Pmitrega/LinefollowerV3/matlab_learn_NN/lfmap_div4_sizemm.bmp

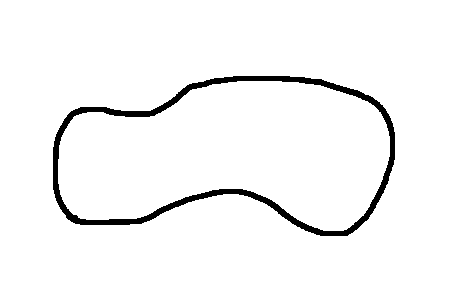
matlab_learn_NN/lfmap_div4_sizemm.bmp
