Pmitrega/LinefollowerV3/matlab_simulation/Robot_simulink/lfmap2.bmp

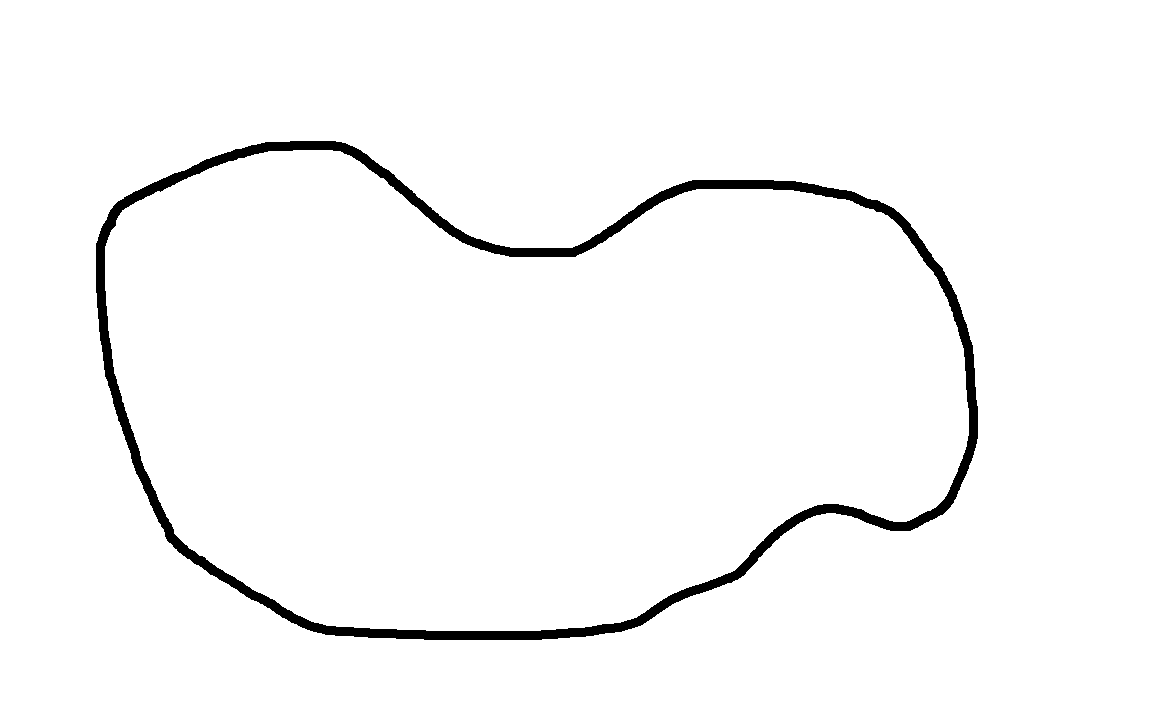
matlab_simulation/Robot_simulink/lfmap2.bmp
