Pmitrega/LinefollowerV3/matlab_simulation/Robot_simulink/robot_im.bmp

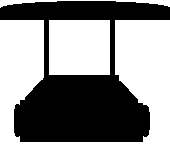
matlab_simulation/Robot_simulink/robot_im.bmp
