Pmitrega/LinefollowerV3/(list of files, cad)

Other CAD files:
modele_3d/connector_meta_v2l.ipt
modele_3d/formav2.ipt
modele_3d/kolov2.ipt
