Pmitrega/LinefollowerV3/BOARD_lfv3_1/BOARD_lfv3.kicad_pcb

## KiCad design BOARD_lfv3_1/BOARD_lfv3.kicad_pcb (2023-09-13)

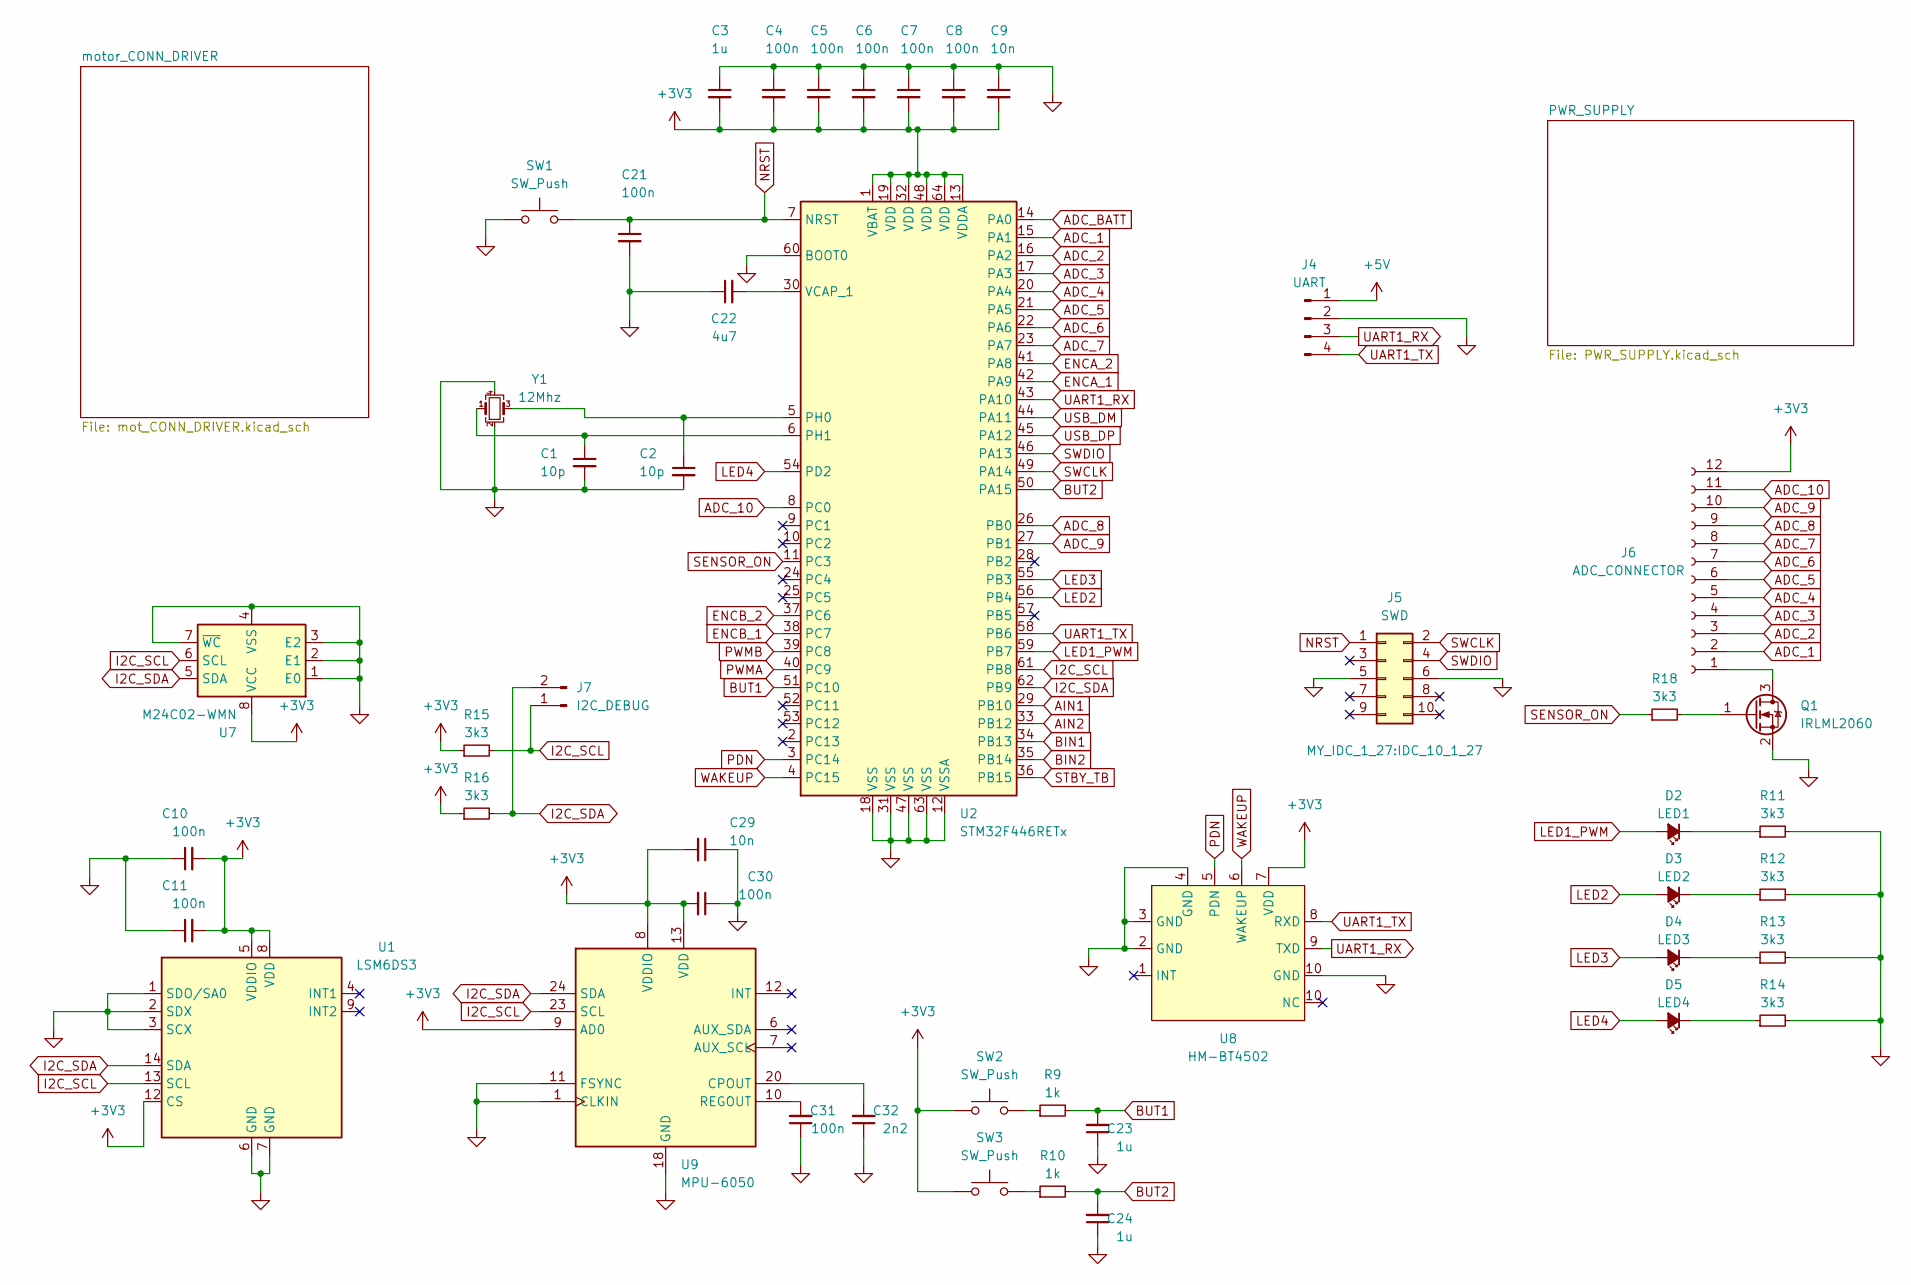
[picture p4: schematic BOARD_lfv3.kicad_sch]

Parts:
C1, C2: 10p; C_0603_1608Metric_Pad1.08x0.95mm_HandSolder
C3, C23, C24: 1u; C_0603_1608Metric_Pad1.08x0.95mm_HandSolder
C4, C5, C6, C7, C8, C10, C11, C21, C30, C31: 100n; C_0603_1608Metric_Pad1.08x0.95mm_HandSolder
C9, C29: 10n; C_0603_1608Metric_Pad1.08x0.95mm_HandSolder
C22: 4u7; C_0603_1608Metric_Pad1.08x0.95mm_HandSolder
C32: 2n2; C_0603_1608Metric_Pad1.08x0.95mm_HandSolder
D2: LED1; LED_0603_1608Metric_Pad1.05x0.95mm_HandSolder
D3: LED2; LED_0603_1608Metric_Pad1.05x0.95mm_HandSolder
D4: LED3; LED_0603_1608Metric_Pad1.05x0.95mm_HandSolder
D5: LED4; LED_0603_1608Metric_Pad1.05x0.95mm_HandSolder
J4: UART; PinSocket_1x04_P2.54mm_Vertical
J5: SWD; IDC_10_1_27
J6: ADC_CONNECTOR; Hirose_FH12-12S-0.5SH_1x12-1MP_P0.50mm_Horizontal
J7: I2C_DEBUG; PinHeader_1x02_P2.54mm_Vertical
Q1: IRLML2060; SOT-23
R9, R10: 1k; R_0603_1608Metric_Pad0.98x0.95mm_HandSolder
R11, R12, R13, R14, R15, R16, R18: 3k3; R_0603_1608Metric_Pad0.98x0.95mm_HandSolder
SW1, SW2, SW3: SW_Push; SW_SPST_TL3342
U1: LSM6DS3; LGA-14_3x2.5mm_P0.5mm_LayoutBorder3x4y
U2: STM32F446RETx; LQFP-64_10x10mm_P0.5mm
U7: M24C02-WMN; SOIC-8_3.9x4.9mm_P1.27mm
U8: HM-BT4502; HM-BT4502_kopia
U9: MPU-6050; InvenSense_QFN-24_4x4mm_P0.5mm
Y1: 12Mhz; Crystal_SMD_3225-4Pin_3.2x2.5mm_HandSoldering

Connections:
+3V3: C3.2, C4.2, C5.2, C6.2, C7.2, C8.2, C9.2, C10.2, C11.2, C29.2, C30.2, J6.12, R15.1, R16.1, SW2.1, SW3.1, U1.5 (VDDIO), U1.8 (VDD), U1.12 (CS), U2.1 (VBAT), U2.13 (VDDA), U2.19 (VDD), U2.32 (VDD), U2.48 (VDD), U2.64 (VDD), U7.8 (VCC), U8.7 (VDD), U9.8 (VDDIO), U9.9 (AD0), U9.13 (VDD); also elsewhere on the board
+5V: J4.1; also elsewhere on the board
ADC_1: J6.2, U2.15 (PA1)
ADC_2: J6.3, U2.16 (PA2)
ADC_3: J6.4, U2.17 (PA3)
ADC_4: J6.5, U2.20 (PA4)
ADC_5: J6.6, U2.21 (PA5)
ADC_6: J6.7, U2.22 (PA6)
ADC_7: J6.8, U2.23 (PA7)
ADC_8: J6.9, U2.26 (PB0)
ADC_9: J6.10, U2.27 (PB1)
ADC_10: J6.11, U2.8 (PC0)
ADC_BATT: U2.14 (PA0); also elsewhere on the board
AIN1: U2.29 (PB10); also elsewhere on the board
AIN2: U2.33 (PB12); also elsewhere on the board
BIN1: U2.34 (PB13); also elsewhere on the board
BIN2: U2.35 (PB14); also elsewhere on the board
BUT1: C23.2, R9.2, U2.51 (PC10)
BUT2: C24.2, R10.2, U2.50 (PA15)
ENCA_1: U2.42 (PA9); also elsewhere on the board
ENCA_2: U2.41 (PA8); also elsewhere on the board
ENCB_1: U2.38 (PC7); also elsewhere on the board
ENCB_2: U2.37 (PC6); also elsewhere on the board
GND: C1.2, C2.2, C3.1, C4.1, C5.1, C6.1, C7.1, C8.1, C9.1, C10.1, C11.1, C21.2, C22.1, C23.1, C24.1, C29.1, C30.1, C31.1, C32.1, J4.2, J5.5, J5.6, Q1.2 (S), R11.2, R12.2, R13.2, R14.2, SW1.1, U1.1 (SDO/SA0), U1.2 (SDX), U1.3 (SCX), U1.6 (GND), U1.7 (GND), U2.12 (VSSA), U2.18 (VSS), U2.31 (VSS), U2.47 (VSS), U2.60 (BOOT0), U2.63 (VSS), U7.1 (E0), U7.2 (E1), U7.3 (E2), U7.4 (VSS), U7.7 (~WC), U8.2 (GND), U8.3 (GND), U8.4 (GND), U8.10 (GND), U9.1 (CLKIN), U9.11 (FSYNC), U9.18 (GND), Y1.2, Y1.4; also elsewhere on the board
I2C_SCL: J7.1, R15.2, U1.13 (SCL), U2.61 (PB8), U7.6 (SCL), U9.23 (SCL)
I2C_SDA: J7.2, R16.2, U1.14 (SDA), U2.62 (PB9), U7.5 (SDA), U9.24 (SDA)
LED1_PWM: D2.2 (A), U2.59 (PB7)
LED2: D3.2 (A), U2.56 (PB4)
LED3: D4.2 (A), U2.55 (PB3)
LED4: D5.2 (A), U2.54 (PD2)
NRST: C21.1, J5.1, SW1.2, U2.7 (NRST)
unnamed: C1.1, U2.6 (PH1), Y1.1
unnamed: C2.1, U2.5 (PH0), Y1.3
unnamed: C22.2, U2.30 (VCAP_1)
unnamed: C31.2, U9.10 (REGOUT)
unnamed: C32.2, U9.20 (CPOUT)
unnamed: D2.1 (K), R11.1
unnamed: D3.1 (K), R12.1
unnamed: D4.1 (K), R13.1
unnamed: D5.1 (K), R14.1
unnamed: J6.1, Q1.3 (D)
unnamed: Q1.1 (G), R18.2
unnamed: R9.1, SW2.2
unnamed: R10.1, SW3.2
PDN: U2.3 (PC14), U8.5 (PDN)
PWMA: U2.40 (PC9); also elsewhere on the board
PWMB: U2.39 (PC8); also elsewhere on the board
SENSOR_ON: R18.1, U2.11 (PC3)
STBY_TB: U2.36 (PB15); also elsewhere on the board
SWCLK: J5.2, U2.49 (PA14)
SWDIO: J5.4, U2.46 (PA13)
UART1_RX: J4.3, U2.43 (PA10), U8.9 (TXD)
UART1_TX: J4.4, U2.58 (PB6), U8.8 (RXD)
USB_DM: U2.44 (PA11)
USB_DP: U2.45 (PA12)
WAKEUP: U2.4 (PC15), U8.6 (WAKEUP)

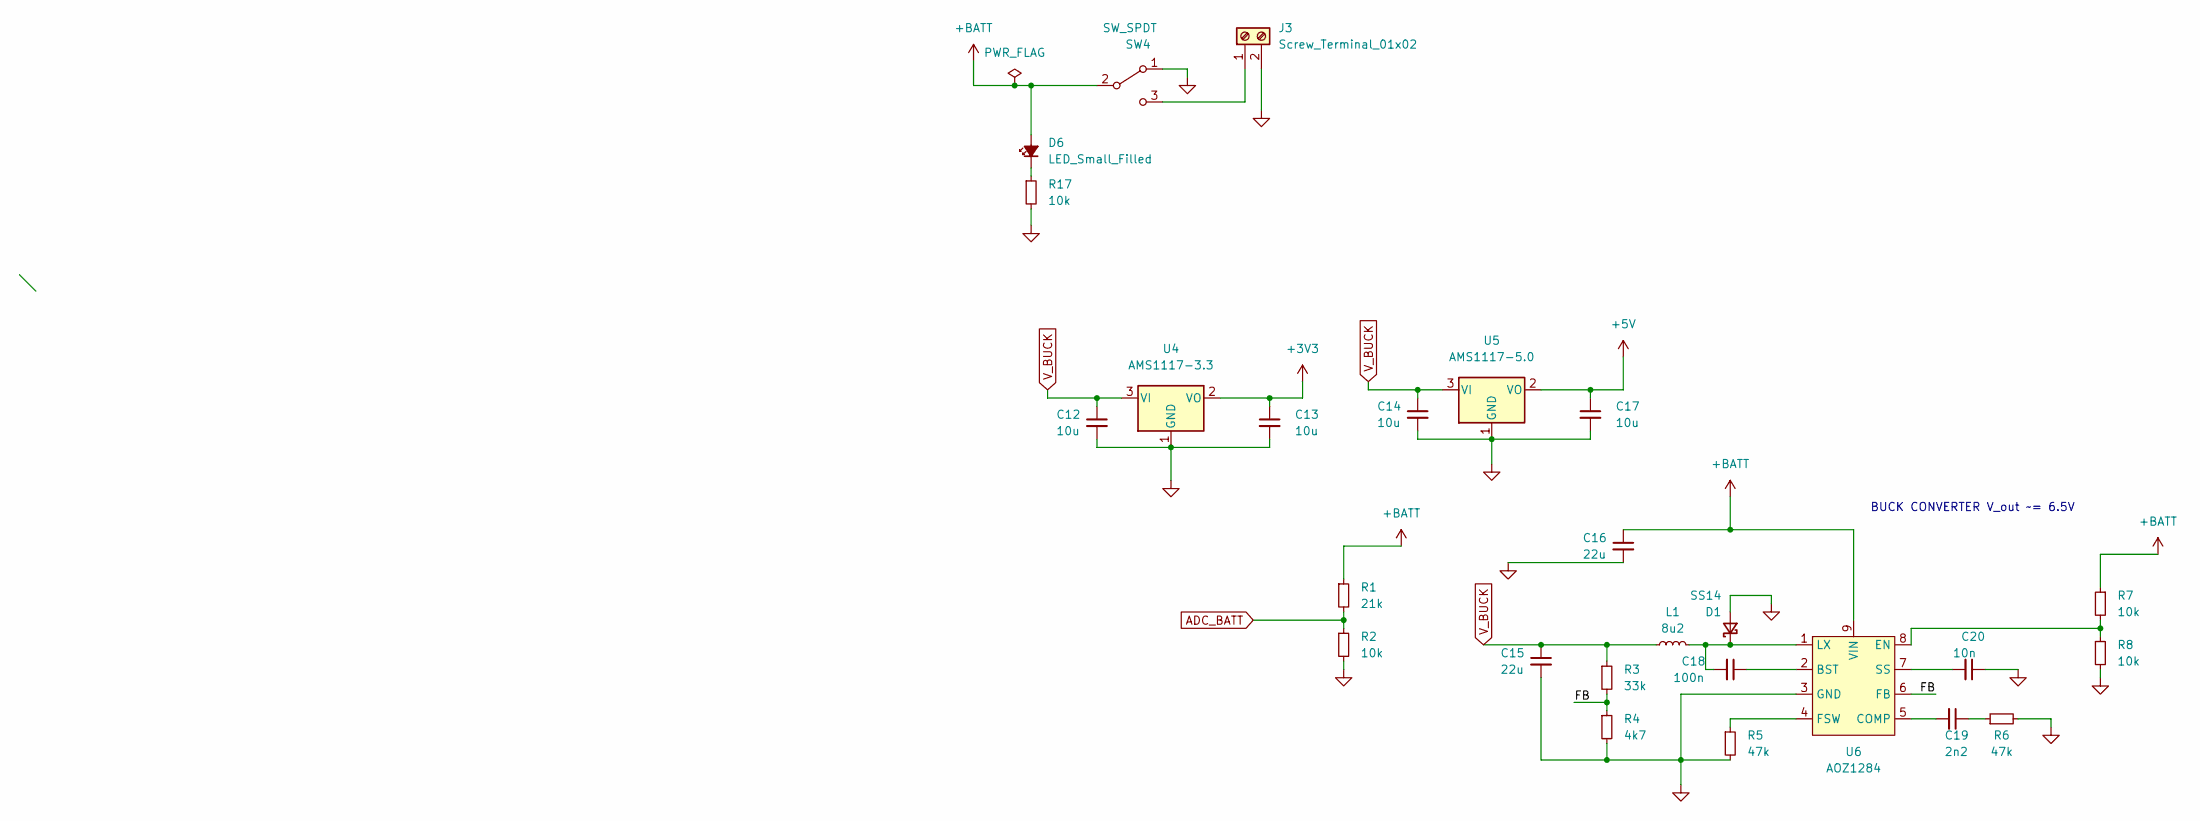
[picture p5: schematic PWR_SUPPLY.kicad_sch]

Parts:
C12, C13, C14, C17: 10u; C_0603_1608Metric_Pad1.08x0.95mm_HandSolder
C15, C16: 22u; C_0805_2012Metric_Pad1.18x1.45mm_HandSolder
C18: 100n; C_0603_1608Metric_Pad1.08x0.95mm_HandSolder
C19: 2n2; C_0603_1608Metric_Pad1.08x0.95mm_HandSolder
C20: 10n; C_0603_1608Metric_Pad1.08x0.95mm_HandSolder
D1: SS14; D_SMA_Handsoldering
D6: LED_Small_Filled; LED_0603_1608Metric_Pad1.05x0.95mm_HandSolder
J3: Screw_Terminal_01x02; TerminalBlock_4Ucon_1x02_P3.50mm_Horizontal
L1: 8u2; L_7.3x7.3_H4.5
R1: 21k; R_0603_1608Metric_Pad0.98x0.95mm_HandSolder
R2, R7, R8, R17: 10k; R_0603_1608Metric_Pad0.98x0.95mm_HandSolder
R3: 33k; R_0603_1608Metric_Pad0.98x0.95mm_HandSolder
R4: 4k7; R_0603_1608Metric_Pad0.98x0.95mm_HandSolder
R5, R6: 47k; R_0603_1608Metric_Pad0.98x0.95mm_HandSolder
SW4: SW_SPDT; SS22T20
U4: AMS1117-3.3; SOT-223-3_TabPin2
U5: AMS1117-5.0; SOT-223-3_TabPin2
U6: AOZ1284; SO-8-pad

Connections:
+3V3: C13.1, U4.2 (VO); also elsewhere on the board
+5V: C17.1, U5.2 (VO); also elsewhere on the board
+BATT: C16.1, D6.2 (A), R1.1, R7.1, SW4.2 (B), U6.9 (VIN)
/PWR_SUPPLY/FB: R3.2, R4.1, U6.6 (FB)
ADC_BATT: R1.2, R2.1; also elsewhere on the board
GND: C12.2, C13.2, C14.2, C15.2, C16.2, C17.2, C20.1, D1.2 (A), J3.2, R2.2, R4.2, R5.2, R6.2, R8.2, R17.2, SW4.1 (A), U4.1 (GND), U5.1 (GND), U6.3 (GND); also elsewhere on the board
unnamed: C18.1, U6.2 (BST)
unnamed: C18.2, D1.1 (K), L1.2, U6.1 (LX)
unnamed: C19.1, R6.1
unnamed: C19.2, U6.5 (COMP)
unnamed: C20.2, U6.7 (SS)
unnamed: D6.1 (K), R17.1
unnamed: J3.1, SW4.3 (C)
unnamed: R5.1, U6.4 (FSW)
unnamed: R7.2, R8.1, U6.8 (EN)
V_BUCK: C12.1, C14.1, C15.1, L1.1, R3.1, U4.3 (VI), U5.3 (VI); also elsewhere on the board

Notes on the sheet:
BUCK CONVERTER V_out ~= 6.5V

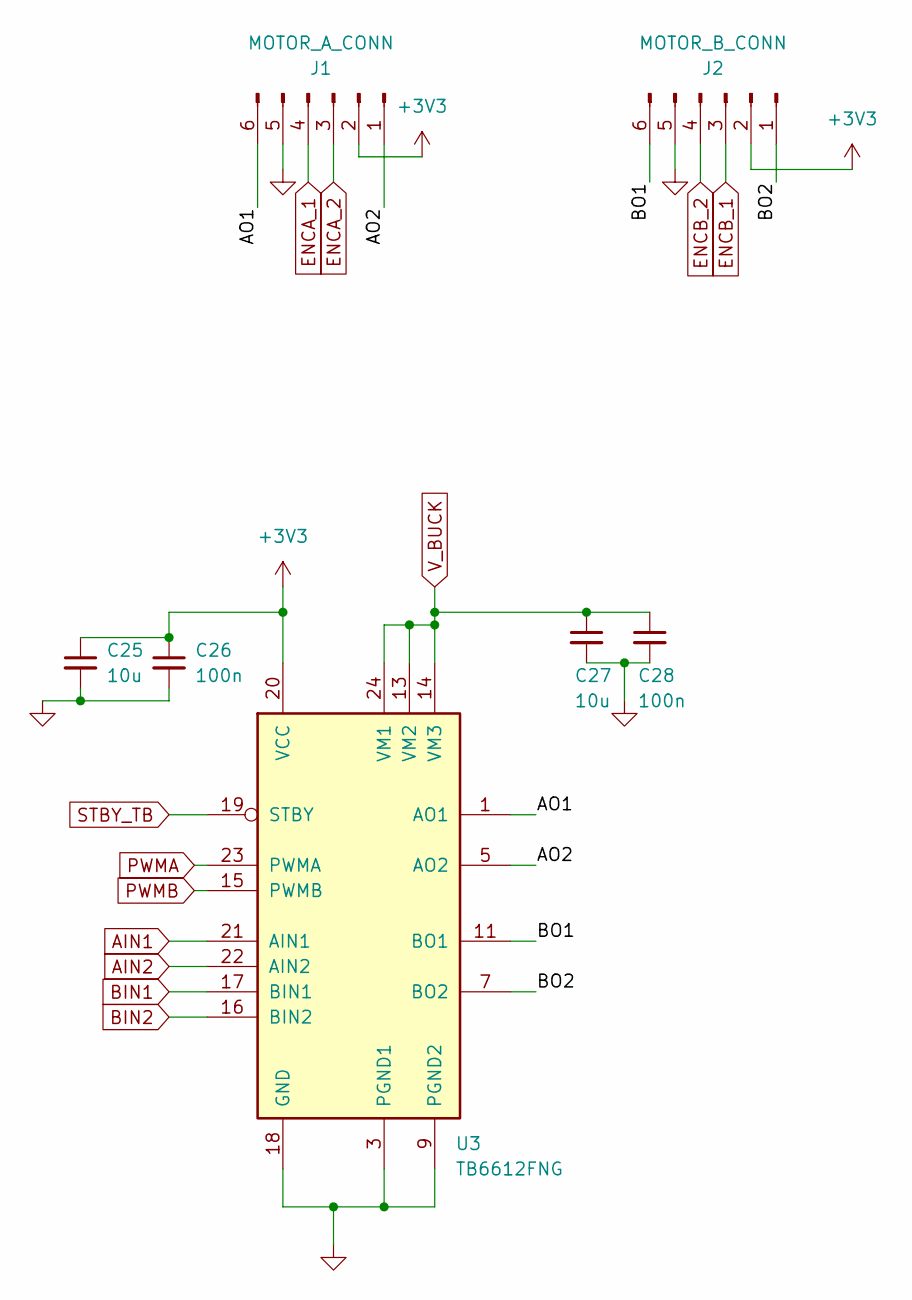
[picture p6: schematic mot_CONN_DRIVER.kicad_sch]

Parts:
C25, C27: 10u; C_0805_2012Metric_Pad1.18x1.45mm_HandSolder
C26, C28: 100n; C_0603_1608Metric_Pad1.08x0.95mm_HandSolder
J1: MOTOR_A_CONN; JST_XH_B6B-XH-A_1x06_P2.50mm_Vertical
J2: MOTOR_B_CONN; JST_XH_B6B-XH-A_1x06_P2.50mm_Vertical
U3: TB6612FNG; SSOP-24_5.3x8.2mm_P0.65mm

Connections:
+3V3: C25.1, C26.1, J1.2, J2.2, U3.20 (VCC); also elsewhere on the board
/motor_CONN_DRIVER/AO1: J1.6, U3.1 (AO1), U3.2 (AO1)
/motor_CONN_DRIVER/AO2: J1.1, U3.5 (AO2), U3.6 (AO2)
/motor_CONN_DRIVER/BO1: J2.6, U3.11 (BO1), U3.12 (BO1)
/motor_CONN_DRIVER/BO2: J2.1, U3.7 (BO2), U3.8 (BO2)
AIN1: U3.21 (AIN1); also elsewhere on the board
AIN2: U3.22 (AIN2); also elsewhere on the board
BIN1: U3.17 (BIN1); also elsewhere on the board
BIN2: U3.16 (BIN2); also elsewhere on the board
ENCA_1: J1.4; also elsewhere on the board
ENCA_2: J1.3; also elsewhere on the board
ENCB_1: J2.3; also elsewhere on the board
ENCB_2: J2.4; also elsewhere on the board
GND: C25.2, C26.2, C27.2, C28.2, J1.5, J2.5, U3.3 (PGND1), U3.4 (PGND1), U3.9 (PGND2), U3.10 (PGND2), U3.18 (GND); also elsewhere on the board
PWMA: U3.23 (PWMA); also elsewhere on the board
PWMB: U3.15 (PWMB); also elsewhere on the board
STBY_TB: U3.19 (STBY); also elsewhere on the board
V_BUCK: C27.1, C28.1, U3.13 (VM2), U3.14 (VM3), U3.24 (VM1); also elsewhere on the board

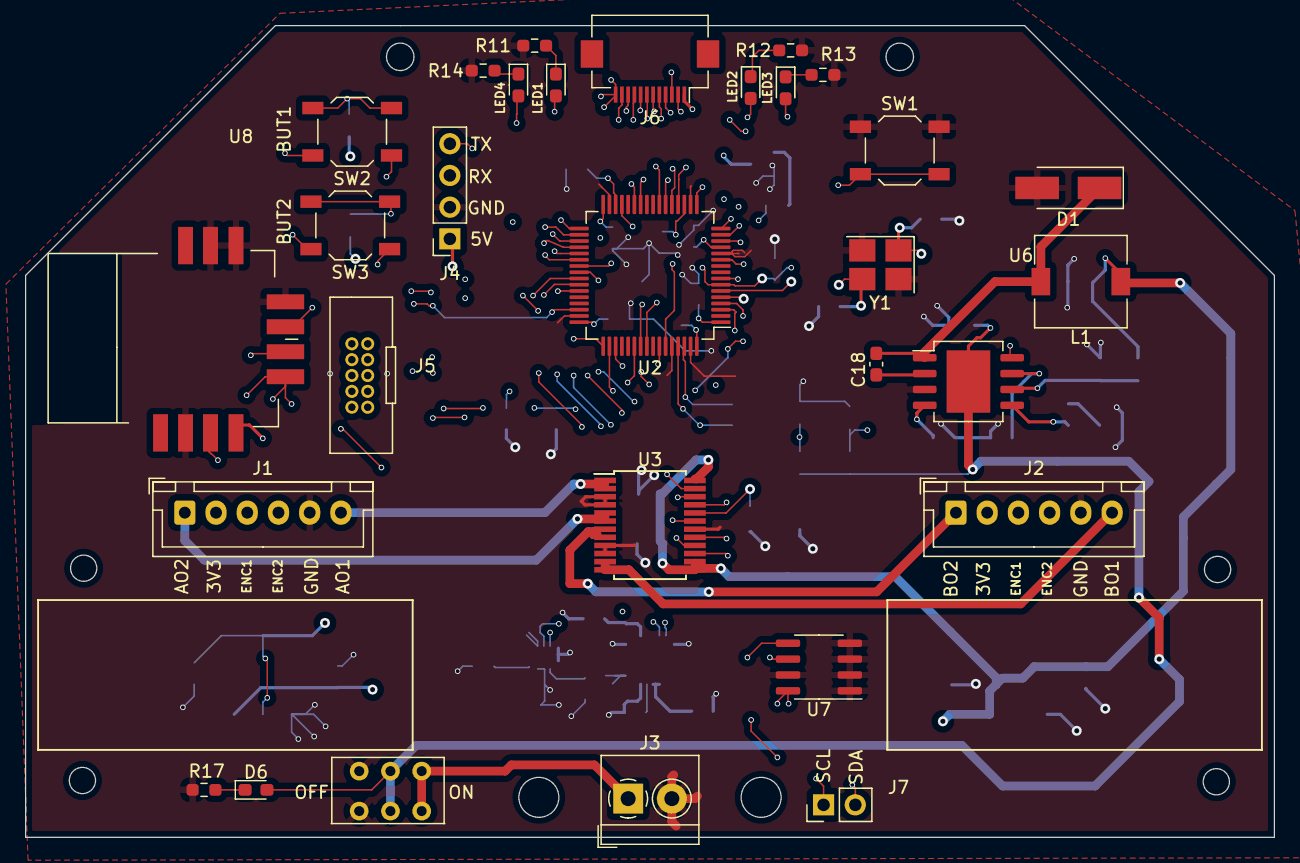
[picture p7: board BOARD_lfv3.kicad_pcb from above]

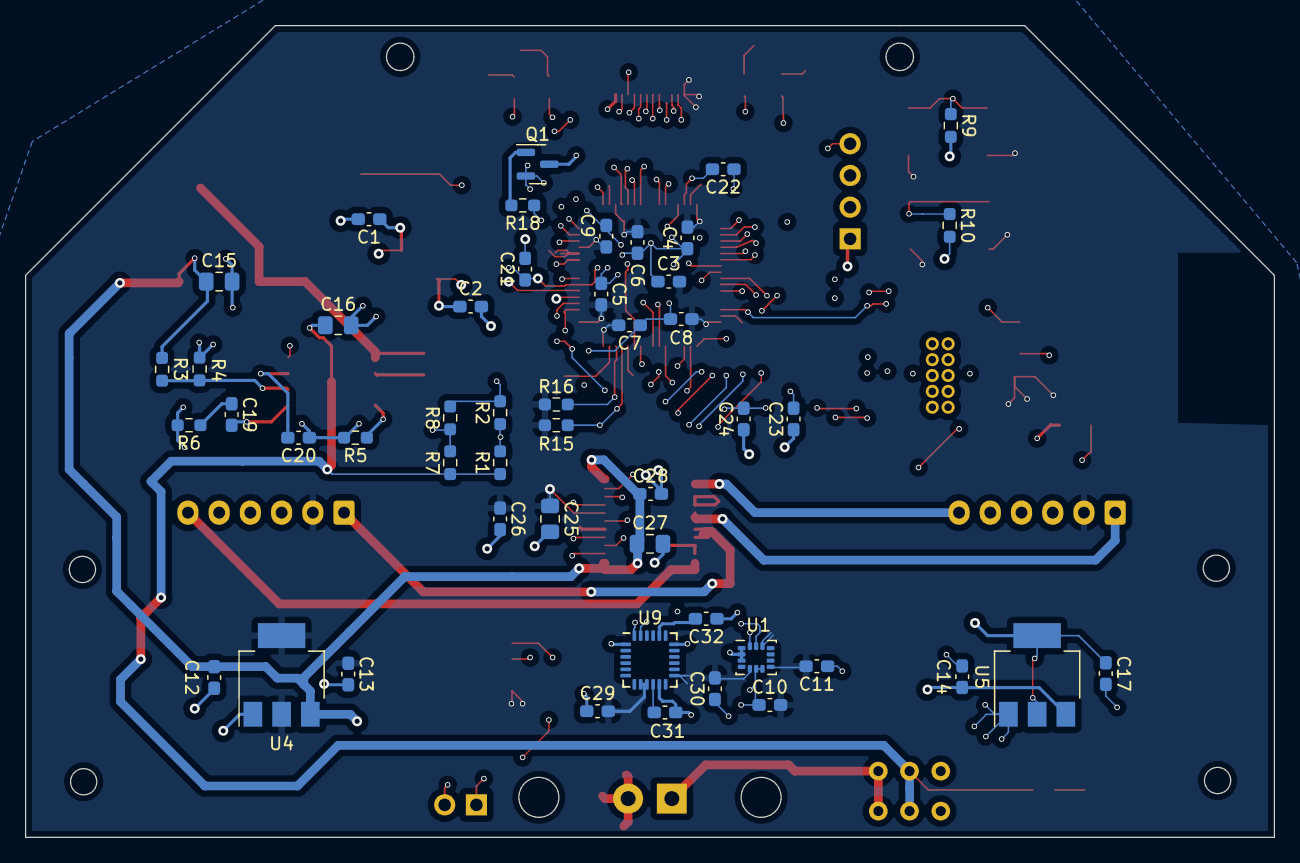
[picture p8: board BOARD_lfv3.kicad_pcb from below]

Board: 4 copper layers, 100.0 x 65.0 mm, 79 parts (49 on the bottom side), 70 nets.
