Pmitrega/LinefollowerV3/Linefollower_V3_code/Core/Src/main.c

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
/* Includes ------------------------------------------------------------------*/
#include "main.h"

/* USER CODE BEGIN Includes */
#include "memory.h"
#include <stdio.h>
#include "MPU6050.h"
#include "battery.h"
#include "line_sensors.h"
#include "IMU.h"
#include "motors.h"
#include "uart_handler.h"
#include "line_sensors.h"
#include "state_machine_ctrl.h"
#include "lf_control.h"
#include "data_loging.h"
/* USER CODE END Includes */

/* USER CODE BEGIN PD */
#define OPERATION_MODE_NORMAL 0
#define OPERATION_MODE_TEST_STRAIGHT 1
#define OPERATION_MODE_TEST_SPIN 2
#define OPERATION_MODE_TEST_MOTORS 3

#define CONTROL_MODE_PID_LOG_DATA 0
#define CONTROL_MODE_NEURAL_NETWORK 1
#define CONTROL_MODE_NO_CONTROL 2

#define CONTROL_MODE CONTROL_MODE_NEURAL_NETWORK
#define OPERATION_MODE OPERATION_MODE_TEST_MOTORS

#define DISABLE_MAIN_WHILE 0

/* USER CODE END PD */

ADC_HandleTypeDef hadc1;
DMA_HandleTypeDef hdma_adc1;

I2C_HandleTypeDef hi2c1;

TIM_HandleTypeDef htim1;
TIM_HandleTypeDef htim3;
TIM_HandleTypeDef htim4;
TIM_HandleTypeDef htim7;
TIM_HandleTypeDef htim8;
TIM_HandleTypeDef htim13;

UART_HandleTypeDef huart1;

/* USER CODE BEGIN PV */
uint32_t adc_reading= 1000;
uint16_t adc_readings[11];
float adc_reading_float;
uint8_t i2c_reading;
extern uint8_t recieve;
extern uint8_t sensors_enable;
extern int velocity_left_int;
extern int velocity_right_int;
extern int desired_left_velocity;
extern int desired_right_velocity;
extern uint8_t black_detection_table[];
extern float sensors_normalized[];
char uart_buffer[100];
extern RobotMode robot_state;
extern uint8_t robot_auto_follow;
float est_angle = 0;
int enable_main_printing = 0;
LogData log_data;
extern float gyro_calib[3];

#if OPERATION_MODE==OPERATION_MODE_TEST_STRAIGHT || OPERATION_MODE==OPERATION_MODE_TEST_SPIN
  uint16_t test_buffer_left[1000];
  uint16_t test_buffer_right[1000];
  uint8_t enable_data_colllection = 0;
  uint8_t send_data = 0;
#endif
/* USER CODE END PV */

void SystemClock_Config(void);
static void MX_GPIO_Init(void);
static void MX_DMA_Init(void);
static void MX_ADC1_Init(void);
static void MX_TIM1_Init(void);
static void MX_TIM3_Init(void);
static void MX_TIM8_Init(void);
static void MX_USART1_UART_Init(void);
static void MX_I2C1_Init(void);
static void MX_TIM4_Init(void);
static void MX_TIM7_Init(void);
static void MX_TIM13_Init(void);
/* USER CODE BEGIN 0 */

void HAL_TIM_PeriodElapsedCallback(TIM_HandleTypeDef *htim){
  static uint16_t tim13_div_cnt = 0;
  static float x[3];
  static float y[6];
  #if OPERATION_MODE == OPERATION_MODE_TEST_STRAIGHT
  static uint32_t go_straight_test_counter = 0;
  #endif
  #if OPERATION_MODE == OPERATION_MODE_TEST_SPIN
  static uint32_t go_spin_test_counter = 0;
  #endif
  if(htim == &htim7){
    //UpdateIMU();

  }
  else if(htim == &htim13){
    #if OPERATION_MODE == OPERATION_MODE_NORMAL
      VelocityEstimation();
      #if CONTROL_MODE == CONTROL_MODE_PID_LOG_DATA
        LeftMotorPID();
        RightMotorPID();
      #endif
        normalize_sensors();

      if(robot_auto_follow){
        #if CONTROL_MODE == CONTROL_MODE_PID_LOG_DATA
          est_angle = -NN_est_angle(sensors_normalized);
          PIDLineControl();
        #elif CONTROL_MODE == CONTROL_MODE_NEURAL_NETWORK
          est_angle = -NN_est_angle(sensors_normalized);
          x[0] = (float)est_angle;
          x[1] = (float)velocity_left_int;
          x[2] = (float)velocity_right_int;
          NeuralNetworkControl(x,y);
          SetLeftMotorPWM(y[1]);
          SetRightMotorPWM(y[0]);
        #endif
      }
      tim13_div_cnt +=1;
      updateLogData(&log_data);
    #elif OPERATION_MODE == OPERATION_MODE_TEST_STRAIGHT

      if(go_straight_test_counter == 1){
       /*start PWM*/
        SetRightMotorPWM(5000);
        SetLeftMotorPWM(5000);
      }
      else if (go_straight_test_counter == 1000)
      {
        /*stop PWM*/
        SetRightMotorPWM(0);
        SetLeftMotorPWM(0);
        send_data = 1;
      }
      if(go_straight_test_counter < 1000){
        test_buffer_left[go_straight_test_counter] = ENCODER_LEFT;
        test_buffer_right[go_straight_test_counter] = ENCODER_RIGHT;
      }
    go_straight_test_counter +=1;
    AdaptiveVelocityEstimation();
    #elif OPERATION_MODE == OPERATION_MODE_TEST_SPIN
    
      if(go_spin_test_counter == 1){
       /*start PWM*/
        SetRightMotorPWM(-5000);
        SetLeftMotorPWM(-5000);
      }
      else if (go_spin_test_counter == 1000)
      {
        /*stop PWM*/
        SetRightMotorPWM(0);
        SetLeftMotorPWM(0);
        send_data = 1;
      }
      if(go_spin_test_counter < 1000){
        test_buffer_left[go_spin_test_counter] = ENCODER_LEFT;
        test_buffer_right[go_spin_test_counter] = ENCODER_RIGHT;
      }
      go_spin_test_counter +=1;
      AdaptiveVelocityEstimation();
    #elif OPERATION_MODE == OPERATION_MODE_TEST_MOTORS
      VelocityEstimation();
    #endif
  }
}

/* USER CODE END 0 */

/**
  * @brief  The application entry point.
  * @retval int
  */
int main(void)
{
  /* MCU Configuration--------------------------------------------------------*/

  /* Reset of all peripherals, Initializes the Flash interface and the Systick. */
  HAL_Init();

  /* Configure the system clock */
  SystemClock_Config();

  /* Initialize all configured peripherals */
  MX_GPIO_Init();
  MX_DMA_Init();
  MX_ADC1_Init();
  MX_TIM1_Init();
  MX_TIM3_Init();
  MX_TIM8_Init();
  MX_USART1_UART_Init();
  MX_I2C1_Init();
  MX_TIM4_Init();
  MX_TIM7_Init();
  MX_TIM13_Init();
  /* USER CODE BEGIN 2 */
  HAL_TIM_PWM_Start(&htim8, TIM_CHANNEL_3);
  HAL_TIM_PWM_Start(&htim8, TIM_CHANNEL_4);
  HAL_TIM_PWM_Start(&htim4, TIM_CHANNEL_2);
  HAL_TIM_Encoder_Start(&htim3,TIM_CHANNEL_ALL);
  HAL_TIM_Encoder_Start(&htim1,TIM_CHANNEL_ALL);
  HAL_ADC_Start_DMA(&hadc1, adc_readings, 11);
  /* USER CODE END 2 */

  /* Infinite loop */
  /* USER CODE BEGIN WHILE */

  HAL_GPIO_WritePin(PDN_GPIO_Port, PDN_Pin, GPIO_PIN_SET);
  HAL_GPIO_WritePin(WAKEUP_GPIO_Port, WAKEUP_Pin, GPIO_PIN_SET);

  HAL_GPIO_WritePin(STBY_TB_GPIO_Port, STBY_TB_Pin, GPIO_PIN_SET);
  HAL_GPIO_WritePin(LED3_GPIO_Port, LED3_Pin, 1);
  log_data.end = 0xDEAD;
  uint8_t read_data;
  uint8_t reading;
  uint8_t uart_buffer[100];
  MPU6050_SETTINGS MPU6050_sett;
  MPU6050_default_setting(&MPU6050_sett);
  MPU6050_sett.ACC_RANGE = MPU6050_ACC_2G;
  MPU6050_sett.GYRO_RANGE = MPU6050_GYRO_1000DPS;
  MPU6050_sett.DLPF = MPU6050_DLPF_5;

  InitEncoders();
  HAL_Delay(30);
  MPU6050_wakeup();
  HAL_Delay(5);
  MPU6050_set_config(&MPU6050_sett);
  HAL_Delay(1);
  update_counter();
  HAL_UART_Receive_IT(&huart1, &recieve, 1);
  TURN_ON_SENSORS();
  HAL_Delay(2000);
  calibrate_gyro();
  HAL_Delay(200);
  HAL_TIM_Base_Start_IT(&htim7);
  /*
    htim13 is controlling test and main control algorithms
  */
  HAL_TIM_Base_Start_IT(&htim13);
  ManageRobotStateMachine(0, 0);
  int disable_counter = 0;
  char dsfsk[3] = "ABC";
  uint8_t uart_debug_buffer[30];
  init_sensors();
  int gyro_r_data[3];
  float gyro_data[3];
  int acc_r_data[3];
  float acc_data[3];
  float est_angle_gyro = 0;
  // desired_left_velocity = 1200;
  // desired_right_velocity = 1200;
  /* USER CODE END 2 */
  /* Infinite loop */
  /* USER CODE BEGIN WHILE */
  while (1)
  {
    #if DISABLE_MAIN_WHILE==0
    HAL_Delay(5);
    battery_monitor();
    if(HAL_GPIO_ReadPin(BUT1_GPIO_Port, BUT1_Pin) && !robot_auto_follow){
      HAL_Delay(500);
      robot_auto_follow = 1;
    }
    if(robot_auto_follow == 1 && (disable_counter > 50000)){
      robot_auto_follow = 0;
      desired_left_velocity = 0;
      desired_right_velocity = 0;
      disable_counter = 0;
    }
    else if(robot_auto_follow == 1){
      disable_counter += 1;
      #if CONTROL_MODE == CONTROL_MODE_PID_LOG_DATA
        HAL_UART_Transmit_IT(&huart1, (uint8_t *)&log_data, 12);
      #endif
    }

    #if CONTROL_MODE == CONTROL_MODE_NO_CONTROL
      int l = sprintf(uart_debug_buffer, "%d %d\n", velocity_left_int, velocity_right_int);
      HAL_UART_Transmit_IT(&huart1, uart_debug_buffer, l);
    #endif
    #if OPERATION_MODE == OPERATION_MODE_TEST_STRAIGHT || OPERATION_MODE == OPERATION_MODE_TEST_SPIN
      if(send_data == 1){
        for(int i =0;i<1000;i++){
          int l = sprintf(uart_buffer, "%d %d\n",test_buffer_left[i], test_buffer_right[i]);
          HAL_UART_Transmit(&huart1, uart_buffer, l, 100);
        }
        send_data = 0;
      }
    #endif
    #else
      if(HAL_GPIO_ReadPin(BUT2_GPIO_Port, BUT2_Pin)){
        HAL_Delay(20);
        UpdateIMU();
        est_angle_gyro += gyro_calib[2] * 0.02f *180.f * 75.f;
        normalize_sensors();
        est_angle = NN_est_angle(sensors_normalized);
        //int l = sprintf(uart_buffer, "%d %d %d %d %d %d %d %d %d %d %d\n", (int)(sensors_normalized[0]*1000), (int)(sensors_normalized[1]*1000),(int)(sensors_normalized[2]*1000),(int)(sensors_normalized[3]*1000),(int)(sensors_normalized[4]*1000),(int)(sensors_normalized[5]*1000),(int)(sensors_normalized[6]*1000),(int)(sensors_normalized[7]*1000),(int)(sensors_normalized[8]*1000),(int)(sensors_normalized[9]*1000), (int)est_angle_gyro*10);
        int l = sprintf(uart_buffer, "%d\n",(int)est_angle);
        HAL_UART_Transmit(&huart1, uart_buffer, l, 100);
      }
    #endif
    #if OPERATION_MODE == OPERATION_MODE_TEST_MOTORS
        int lmotor_pwm = 10000;
        int rmotor_pwm = 10000;
        SetLeftMotorPWM(lmotor_pwm);
        SetRightMotorPWM(rmotor_pwm);
        #define TEST_IT 200
        for(int j = 0; j < TEST_IT;j++){
          lmotor_pwm -= 10000/TEST_IT;
          rmotor_pwm -= 10000/TEST_IT;
          SetLeftMotorPWM(lmotor_pwm);
          SetRightMotorPWM(rmotor_pwm);
          for(int i =0; i <10; i++){
            int l = sprintf(uart_buffer, "%d %d %d\n",(int)velocity_left_int, (int)velocity_right_int, (int)lmotor_pwm);
            HAL_UART_Transmit(&huart1, uart_buffer, l, 100);
            HAL_Delay(20);
            }
          }
        
    #endif
    /* USER CODE END WHILE */

    /* USER CODE BEGIN 3 */
  }
  /* USER CODE END 3 */
}

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
