Pmitrega/LinefollowerV3/Linefollower_V3_code/LFv3.ioc

Mcu.UserName=STM32F446RETx
PA0-WKUP.GPIO_Label=ADC_BATT
PA0-WKUP.Signal=ADCx_IN0
PA1.Signal=ADCx_IN1
PA10.Signal=USART1_RX
PA13.Signal=SYS_JTMS-SWDIO
PA14.Signal=SYS_JTCK-SWCLK
PA15.GPIO_Label=BUT2
PA15.Signal=GPIO_Input
PA2.Signal=ADCx_IN2
PA3.Signal=ADCx_IN3
PA4.Signal=ADCx_IN4
PA5.Signal=ADCx_IN5
PA6.Signal=ADCx_IN6
PA7.Signal=ADCx_IN7
PA8.GPIO_Label=ENCA_2
PA8.Signal=S_TIM1_CH1
PA9.GPIO_Label=ENCA_1
PA9.Signal=S_TIM1_CH2
PB0.Signal=ADCx_IN8
PB1.Signal=ADCx_IN9
PB10.GPIO_Label=AIN1
PB10.Signal=GPIO_Output
PB12.GPIO_Label=AIN2
PB12.Signal=GPIO_Output
PB13.GPIO_Label=BIN1
PB13.Signal=GPIO_Output
PB14.GPIO_Label=BIN2
PB14.Signal=GPIO_Output
PB15.GPIO_Label=STBY_TB
PB15.Signal=GPIO_Output
PB3.GPIO_Label=LED3
PB3.Signal=GPIO_Output
PB4.GPIO_Label=LED2
PB4.Signal=GPIO_Output
PB6.Signal=USART1_TX
PB7.GPIO_Label=LED1_PWM
PB7.Signal=S_TIM4_CH2
PB8.Signal=I2C1_SCL
PB9.Signal=I2C1_SDA
PC0.Signal=ADCx_IN10
PC10.GPIO_Label=BUT1
PC10.Signal=GPIO_Input
PC14-OSC32_IN.GPIO_Label=PDN
PC14-OSC32_IN.Signal=GPIO_Output
PC15-OSC32_OUT.GPIO_Label=WAKEUP
PC15-OSC32_OUT.Signal=GPIO_Output
PC3.GPIO_Label=SENSOR_ON
PC3.Signal=GPIO_Output
PC6.GPIO_Label=ENCB_2
PC6.Signal=S_TIM3_CH1
PC7.GPIO_Label=ENCB_1
PC7.Signal=S_TIM3_CH2
PC8.GPIO_Label=PWMB
PC8.Signal=S_TIM8_CH3
PC9.GPIO_Label=PWMA
PC9.Signal=S_TIM8_CH4
PD2.GPIO_Label=LED4
PD2.Signal=GPIO_Output
PH0-OSC_IN.Signal=RCC_OSC_IN
PH1-OSC_OUT.Signal=RCC_OSC_OUT
