Pmitrega/LinefollowerV3/Linefollower_V3_code/Core/Src/state_machine_ctrl.c

#include "state_machine_ctrl.h"
#include "main.h"
#include "battery.h"
#include "uart_handler.h"
#include <stdio.h>
#include "line_sensors.h"
#include "motors.h"

#define WAIT_FOR_UART()         while(uart_ready == FALSE && timeout_value < WAIT_FOR_UART_TIMEOUT){\
                                timeout_value +=1;}\
                                uart_ready = FALSE

#define ENCODER_LEFT()          htim1.Instance->CNT
#define ENCODER_RIGHT()         htim3.Instance->CNT

RobotMode robot_state = Robot_InitMode;


uint8_t robot_auto_follow = 0;
extern uint16_t adc_readings[];
extern UART_HandleTypeDef huart1;
char uart_buffer_SM[100];
extern uint8_t uart_ready;
extern TIM_HandleTypeDef htim8;
extern TIM_HandleTypeDef htim1;
extern TIM_HandleTypeDef htim3;
extern int desired_left_velocity;
extern int desired_right_velocity;
extern int Linefollower_base_velocity;

void RobotManualModeManager(uint8_t command, int number){
    uint32_t timeout_value = 0;
    if(command == 'l'){
        // SetLeftMotorPWM(number);
        desired_left_velocity = number;
    }
    else if(command == 'r'){
        // SetRightMotorPWM(number);
        desired_right_velocity = number;
    }
    else if(command == 'x'){
        NVIC_SystemReset();
    }
    else if(command == 'k'){
        if(number == 0){
            TURN_OFF_SENSORS();
        }
        else if(number == 1){
            TURN_ON_SENSORS();
        }
        else{
            /*
            Gets current state of line sensors
            */
            WAIT_FOR_UART();
            if(HAL_GPIO_ReadPin(SENSOR_ON_GPIO_Port, SENSOR_ON_Pin)){
                WAIT_FOR_UART();
                HAL_UART_Transmit_IT(&huart1, "K:1\n", 4);
            }
            else{
                WAIT_FOR_UART();
                HAL_UART_Transmit_IT(&huart1, "K:0\n", 4);
            }
        }
    }
    else if(command == 'm'){
        WAIT_FOR_UART();
        robot_state = Robot_AutoMode;
        HAL_UART_Transmit_IT(&huart1, "Entering Auto Mode\n", 20);
        
    }
    else if(command == 'd'){
        if(number == 2){
            HAL_GPIO_TogglePin(LED2_GPIO_Port, LED2_Pin);
        }   
        if(number == 3){
            HAL_GPIO_TogglePin(LED3_GPIO_Port, LED3_Pin);
        }   
        if(number == 4){
            HAL_GPIO_TogglePin(LED4_GPIO_Port, LED4_Pin);
        }    
    }
    else if(command == 'b'){
        WAIT_FOR_UART();
        int l = get_battery_voltage_string(uart_buffer_SM);
        HAL_UART_Transmit_IT(&huart1, uart_buffer_SM, l);
    }
    else if (command == 'e')
    {
        WAIT_FOR_UART();
        /*
        Gets encoder values
        */
        int l = sprintf(uart_buffer_SM, "E:%d %d\n", ENCODER_LEFT(), ENCODER_RIGHT());
        HAL_UART_Transmit_IT(&huart1, uart_buffer_SM, l);
    }
    else if(command == 's'){
        WAIT_FOR_UART();
        /*
        Gets sensors values
        */
        int l = sprintf(uart_buffer_SM, "%d %d %d %d %d %d %d %d %d %d\n", adc_readings[1], adc_readings[2], adc_readings[3], adc_readings[4], adc_readings[5],
                                                                           adc_readings[6], adc_readings[7], adc_readings[8], adc_readings[9], adc_readings[10]);
        HAL_UART_Transmit_IT(&huart1, uart_buffer_SM, l);
    }
    else if (command == 'v')
    {
        WAIT_FOR_UART();
        /*
        Gets encoder values
        */
        Linefollower_base_velocity = number;
        int l = sprintf(uart_buffer_SM, "velocity set to:%d\n", number);
        HAL_UART_Transmit_IT(&huart1, uart_buffer_SM, l);
    }



}

void RobotAutoModeManager(uint8_t command, int number){
    uint32_t timeout_value = 0;
    if(command == 's'){
        if(number == 1){
            /*
            Here we will enable linefollowing
            */
           robot_auto_follow = 1;
        }
        else if(number == 0){
            /*
            Here we will disable linefollower
            */
            desired_left_velocity = 0;
            desired_right_velocity = 0;
            robot_auto_follow = 0;
        }
    }
    else if(command == 'm'){
            WAIT_FOR_UART();
            HAL_UART_Transmit_IT(&huart1, "Entering Manual Mode\n", 22);
            robot_auto_follow = 0;
            desired_left_velocity = 0;
            desired_right_velocity = 0;
            robot_state = Robot_ManualMode;
    }
    else if(command == 'b'){
        WAIT_FOR_UART();
        int l = get_battery_voltage_string(uart_buffer_SM);
        HAL_UART_Transmit_IT(&huart1, uart_buffer_SM, l);
    }
    else if(command == 'l'){
        if(number == 2){
            HAL_GPIO_TogglePin(LED2_GPIO_Port, LED2_Pin);
        }   
        if(number == 3){
            HAL_GPIO_TogglePin(LED3_GPIO_Port, LED3_Pin);
        }   
        if(number == 4){
            HAL_GPIO_TogglePin(LED4_GPIO_Port, LED4_Pin);
        }    
    }
}

void ManageRobotStateMachine(uint8_t command, int number){
    switch (robot_state)
    {
    case Robot_InitMode:
        robot_state = Robot_ManualMode;
        break;
    
    case Robot_ManualMode:
        RobotManualModeManager(command, number);
        break;

    case Robot_AutoMode:
        RobotAutoModeManager(command, number);
        break;
        
    default:
        break;
    }
}
