Pmitrega/LinefollowerV3/(commit log)

2023-09-23 Battery handling
2023-09-28 added velocity estimation
2023-10-03 PID for motors
2023-10-03 fixed uart issue, which prevented writing negative values, battery voltage filtering, motors PID, taken motor characteristic without load.
    [LF_no_load_motor_meassurements.xlsx]
2023-10-04 added docs foler
    [LF_no_load_motor_meassurements.xlsx]
2023-10-18 added 3d models, PID control for linefollowing and started matlab model
    [connector_meta_v2l.ipt, formav2.ipt, kolov2.ipt]
2023-10-22 updated model
    [mess_5000_2000hz_1.csv, mess_5000_2000hz_2.csv, mess_5000_2000hz_back_1.csv, mess_5000_2000hz_back_2.csv, mess_5000_2000hz_spin_1.csv, mess_5000_2000hz_spin_2.csv, mess_5000_2000hz_spin_rev_1.csv, mess_5000_2000hz_spin_rev_2.csv]
2023-11-01 added python script for reading logs
    [readings.csv, readings2.csv, readings3.csv, readings4.csv]
2023-11-01 added leadring NN
    [readings.csv, readings2.csv, readings3.csv, readings4.csv]
2023-11-01 added working NN
    [data_PWM.csv, data_no3.csv, readings.csv]
2023-11-06 added angle estimation using NN
    [data_PWM.csv, data_PWM_2.csv, data_no2.csv, data_no3.csv, merged_data.csv, readings.csv, readings2.csv, readings3.csv]
2023-11-26 updated motor meassurements
    [data_PWM_4_NN_angle.csv]
